lmartorella/olivetti-plu/doc/schematics.pdf

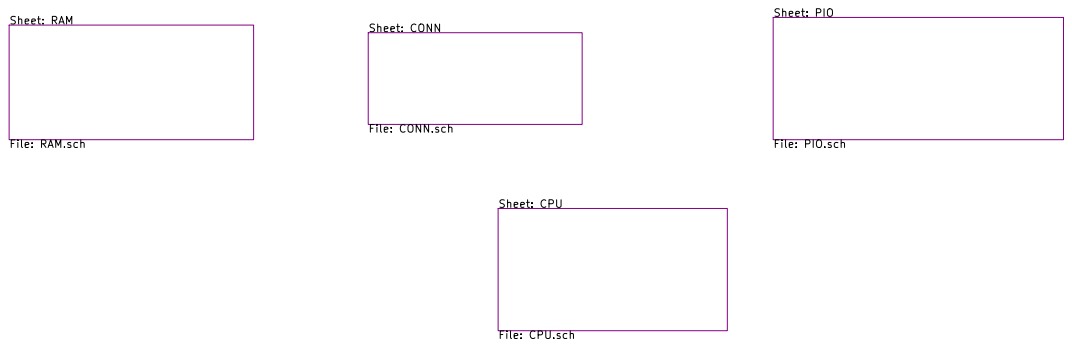
[picture p8: page 1]

File: PIO.sch Sheet: CPU

Id: 1/5 Title: File: olivetti.sch Sheet: /

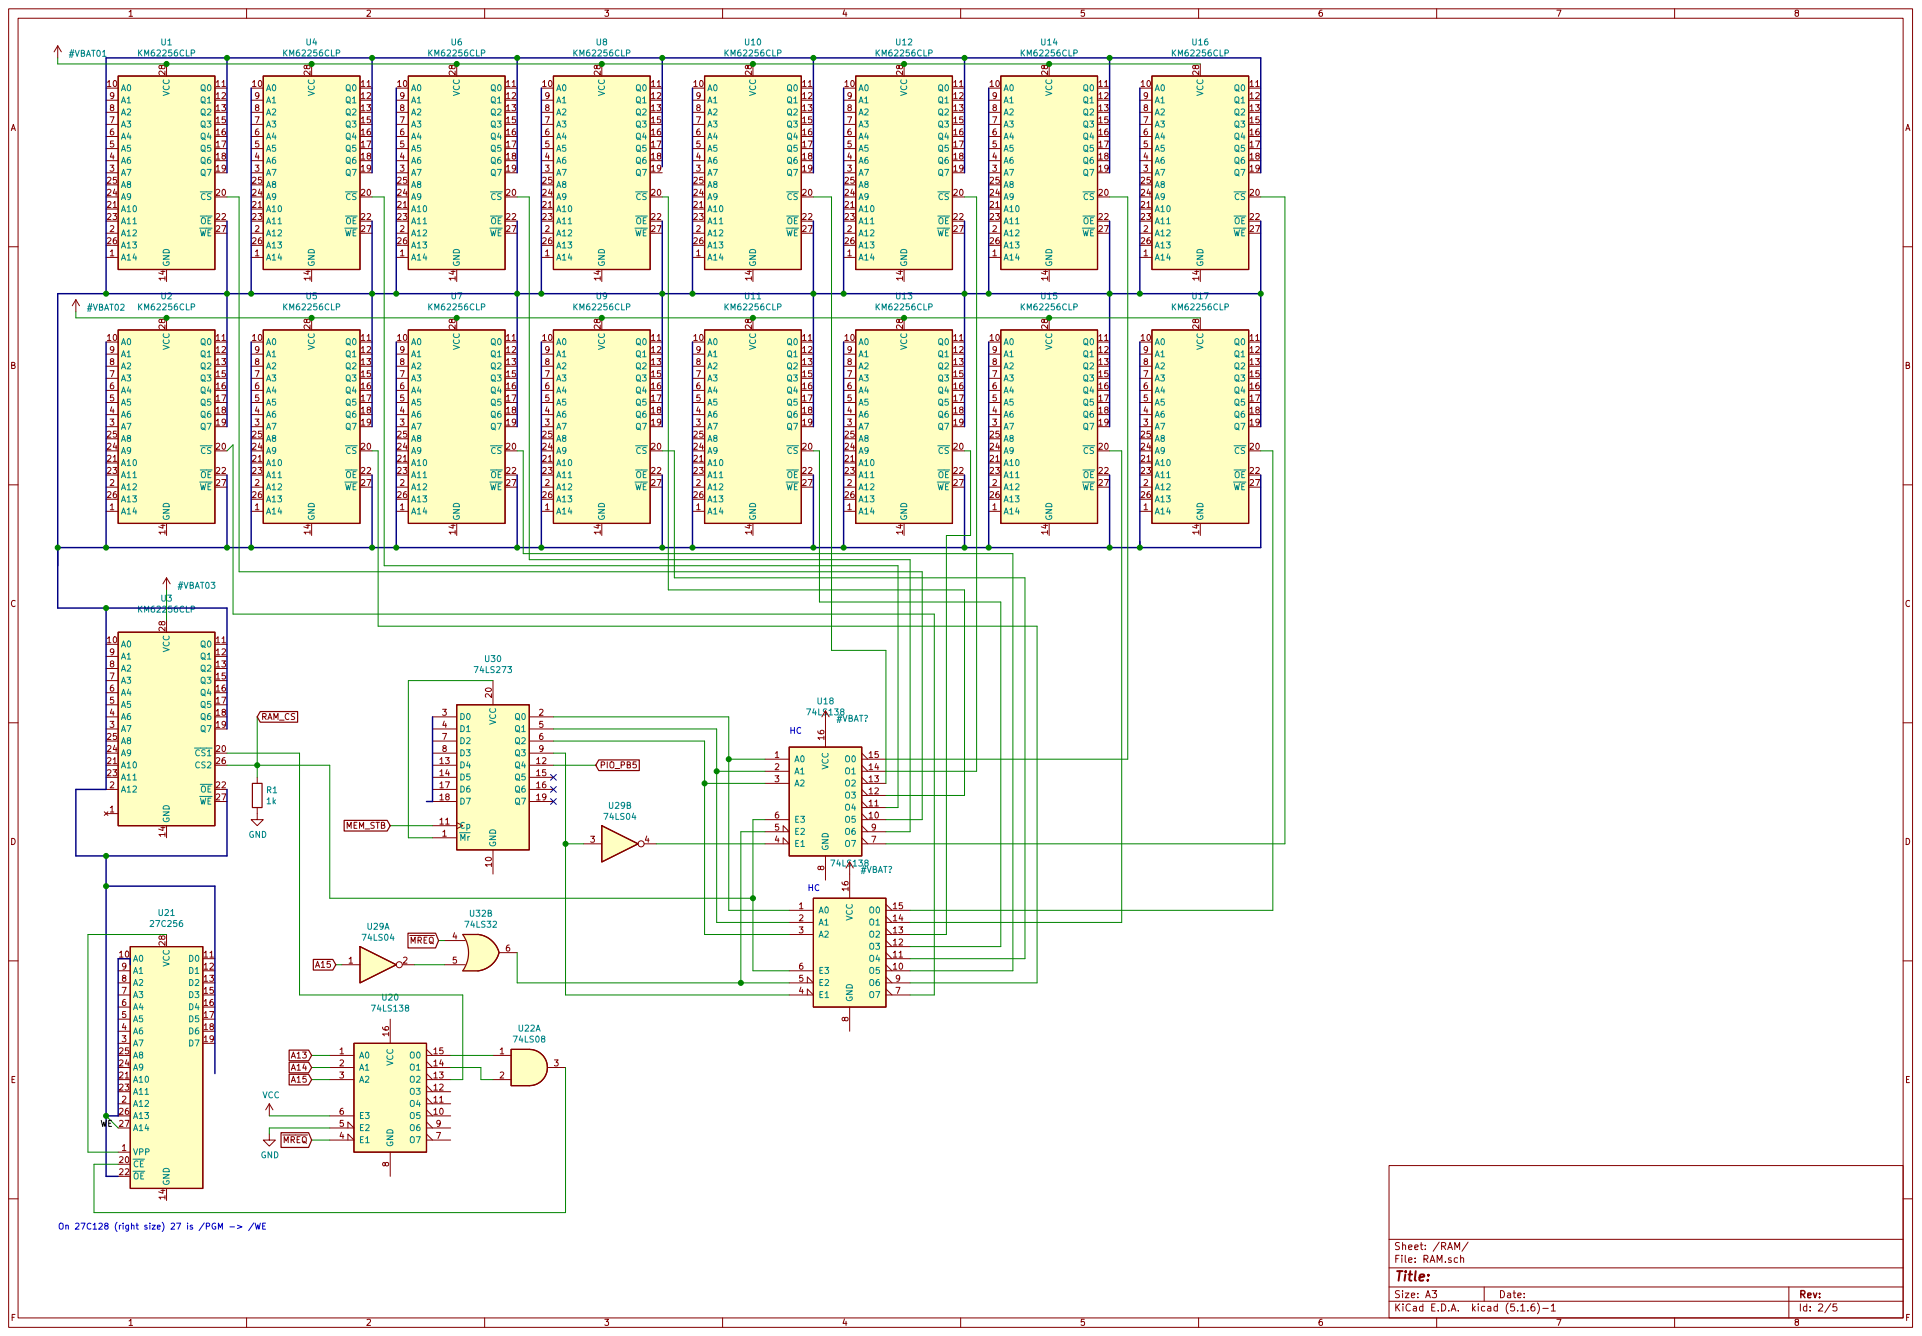
[picture p9: page 2]

Id: 2/5 Title: File: RAM.sch Sheet: /RAM/ GND

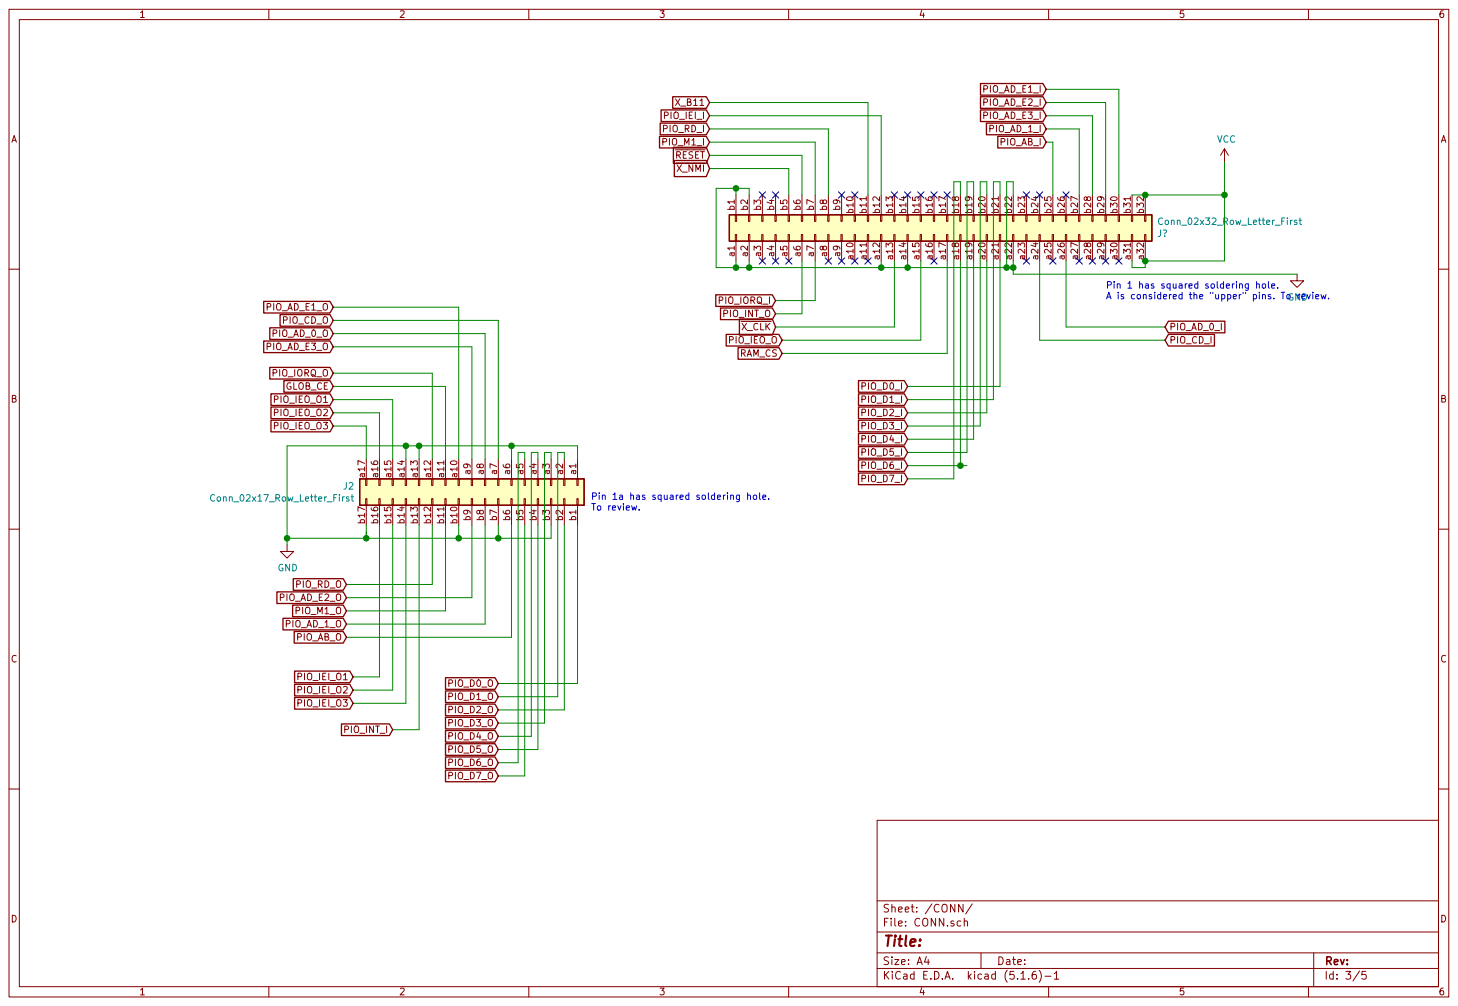
[picture p10: page 3]

A is considered the "upper" pins. To review.

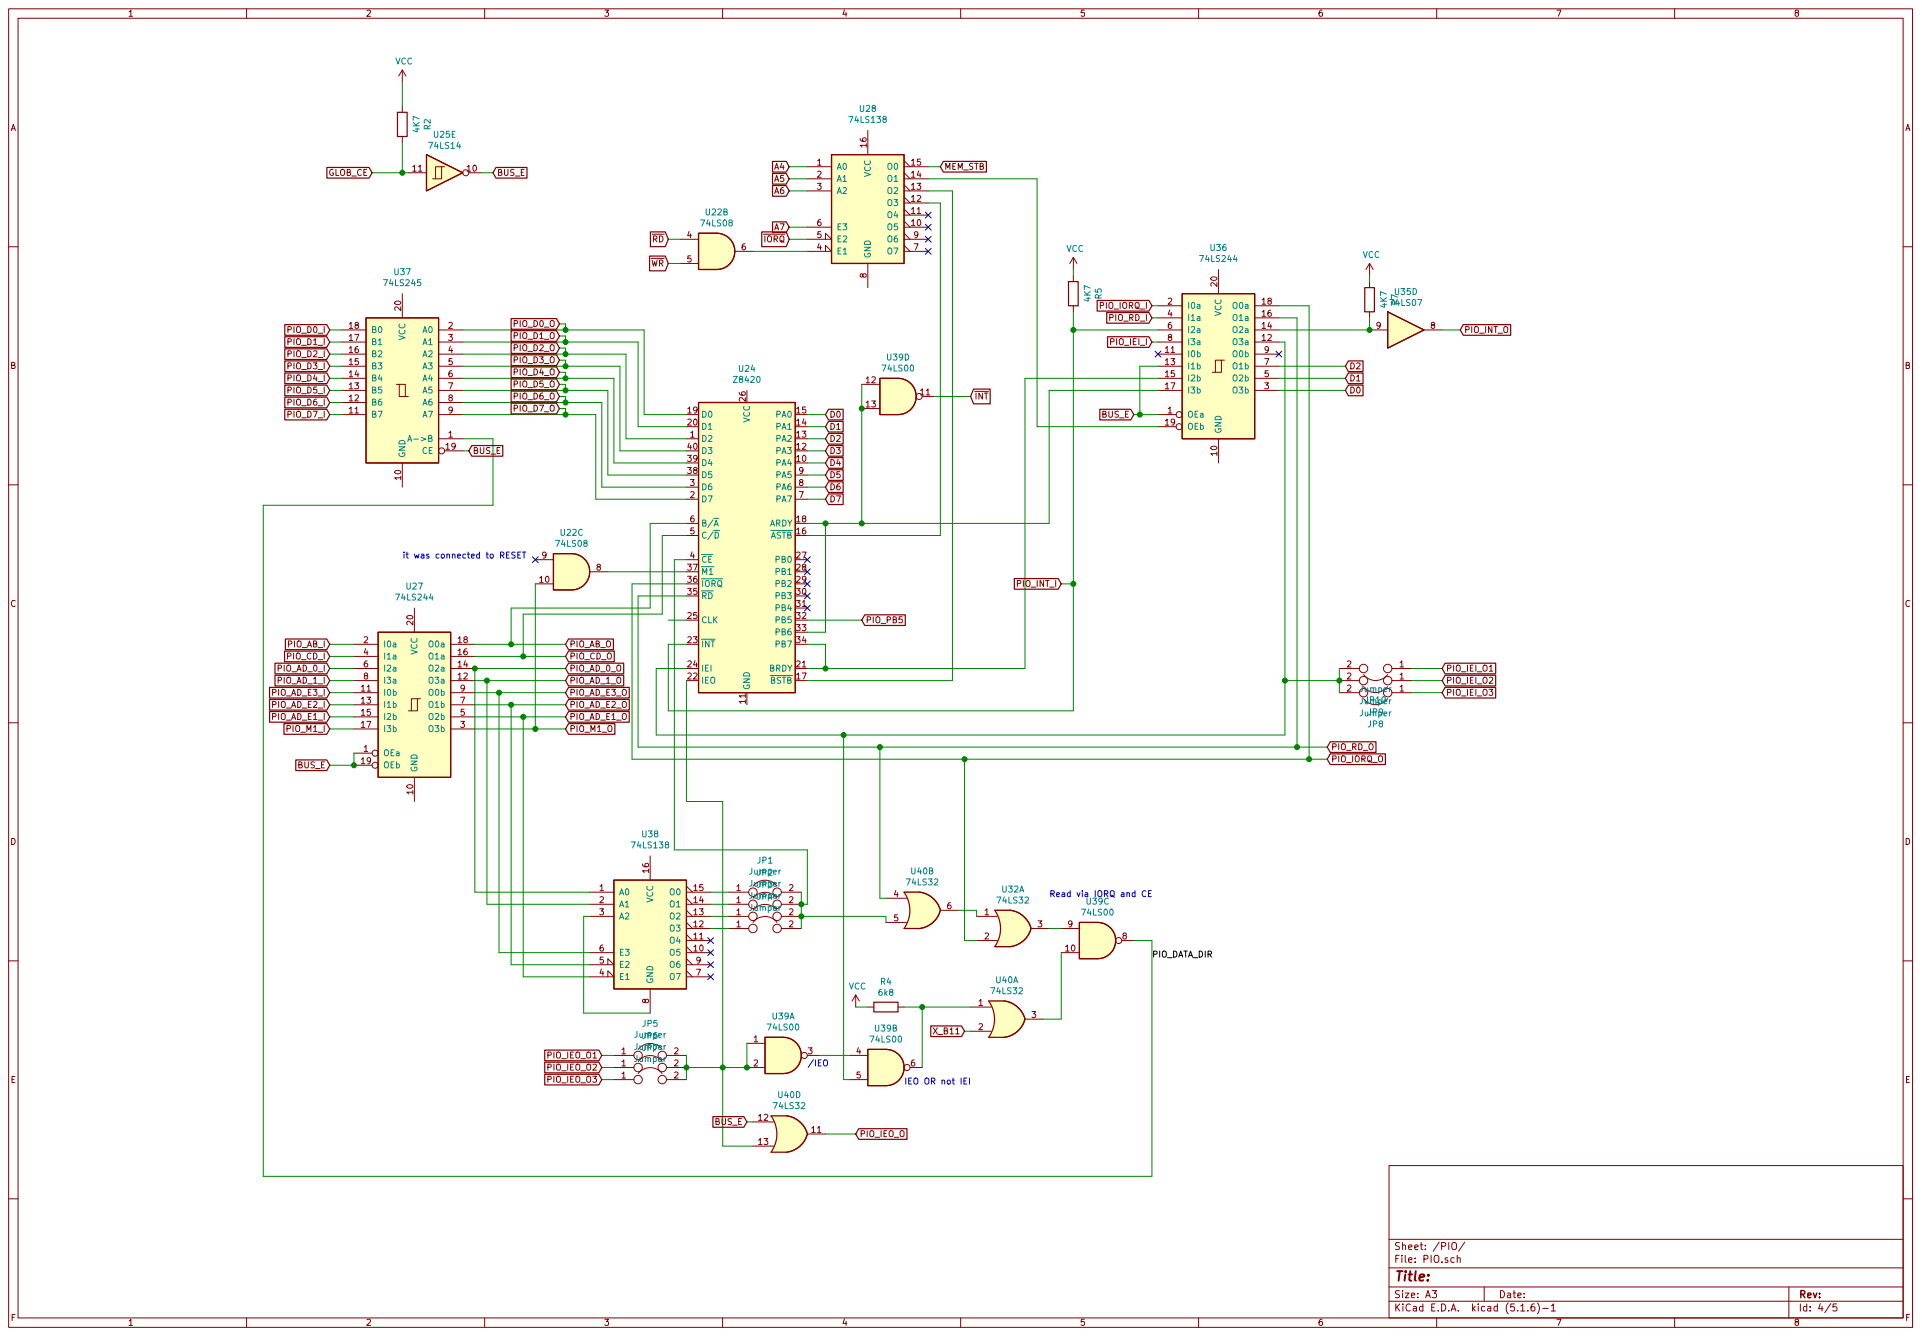
[picture p11: page 4]

it was connected to RESET

Read via IORQ and CE

IEO OR not IEI

Id: 4/5 Title: File: PIO.sch Sheet: /PIO/

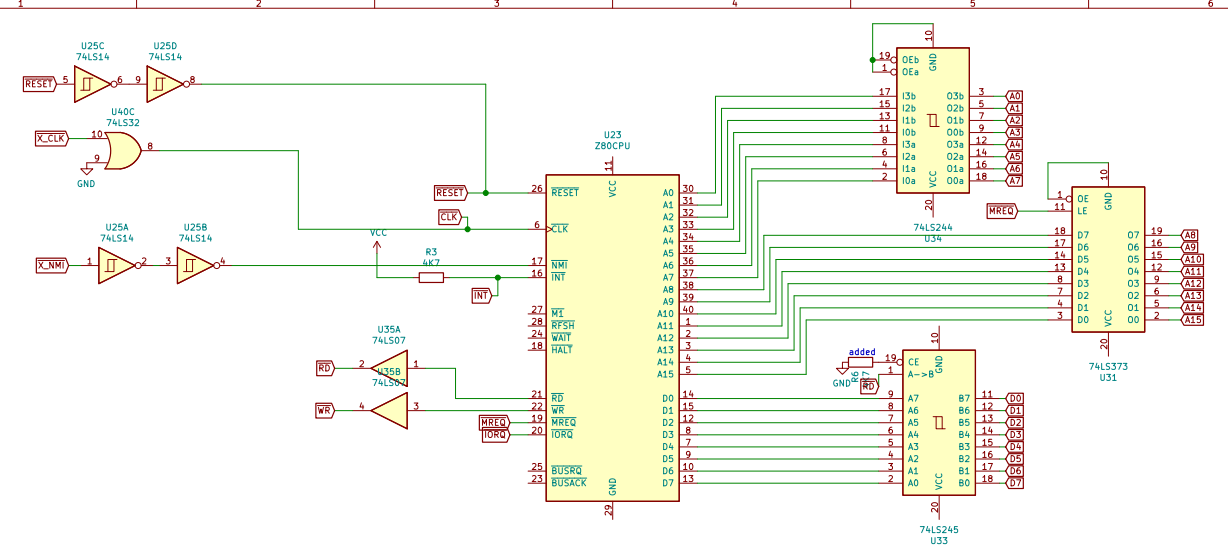
[picture p12: page 5]

Id: 5/5 Title: File: CPU.sch Sheet: /CPU/
